ChillPulse/omnia-v-core/docs/ST7789_8080_8P_MOD_GUIDE.png

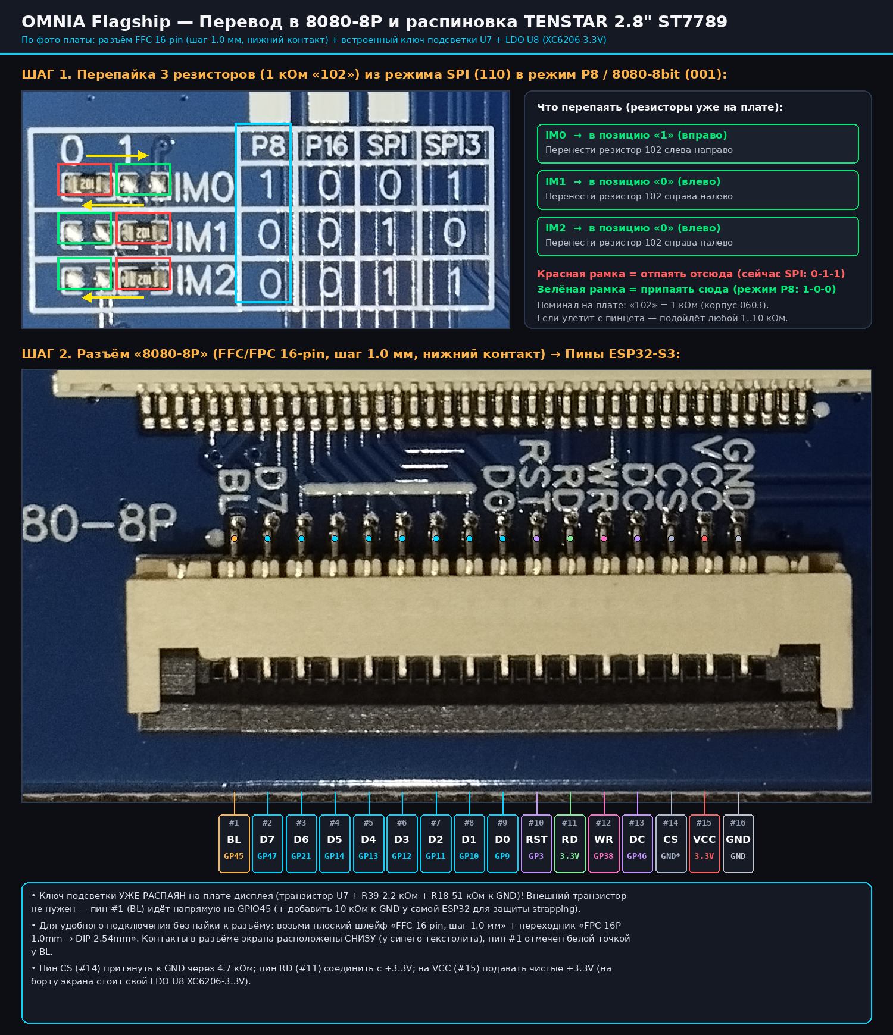
docs/ST7789_8080_8P_MOD_GUIDE.png
