ChillPulse/omnia-v-core/docs/OMNIA_MASTER_SPEC_v2.0.md

# OMNIA Flagship Streamer & Studio DSP — Единое Техническое Задание (Master Spec v2.0)

**Язык спецификации:** Русский (единый эталонный документ архитектуры, схемотехники, протоколов, DSP, UI/UX и плана разработки).  
**Статус документа:** `v2.0 Consolidated & Verified` — объединяет исходный *Master spec OMNIA (v-core) Draft 1.1* со всеми инженерными исправлениями пинов/питания, архитектурой PlatformIO, расширенным DSP (`AETHER Studio`, `Dynamic Loudness`, `A/B Compare`), движком `Zero-Stutter / True Gapless / Radio Time-Shift`, самообучаемым ИК-пультом и ультра-лёгкой PWA.  
**Назначение файла:** Долговременный эталон в рабочей среде (и будущем GitHub-репозитории проекта), исключающий потерю любых деталей между этапами разработки.

---

## 0. Первоисточники и строгая инженерная философия

### 0.1. Базовые референсы
* **Основной концепт OMNIA (v-core):** `https://github.com/ChillPulse/Info-spravka/blob/main/Master%20spec%20OMNIA%20(v-core)`
* **Вспомогательная кодовая база и референсы:**
  * `https://github.com/ChillPulse/Youradio_Omnia_ESP32S3`
  * Наработки STM/I2S из `Info-spravka` (`main.c`, `hal_msp`, `it.c`) — эталон чистого переключения мастер/слейв I2S и бесщёлчковой смены частоты дискретизации (`Fs`).
* **Аппаратная документация (Datasheets):**
  * `ESP32-S3-WROOM-1-N16R8` (16 МБ Quad Flash + 8 МБ Octal PSRAM) и распиновка 44-pin `ESP32-S3-DevKitC-1` (включая особенности китайских клонов и strapping-пинов `0, 3, 45, 46`).
  * `Artery AT32F403ACGU7` (`WeAct BlackPill`, Cortex-M4F 240 МГц с FPU, 1 МБ Flash, 96+128=224 КБ SRAM через `EOPB0`, полнодуплексный `I2S2 + I2S2EXT`).
  * Дисплей `TENSTAR ROBOT 2.8" IPS ST7789 (320×240)` в режиме **8-bit 8080 Parallel (`I80`)** + драйвер ESP-IDF `esp_lcd_i80`.
  * Периферия: `PCM5102A` (GY-PCM5102 purple module), `FSUSB30MUX` (MSOP-10), `74HC125`, `SN74AHCT125N`, `AO3401` + `PPTC 1812 0.75A`, `BH1750` (`0x23`), `TSOP38238/4838` (38 кГц), кольцо `12× WS2812B`, открытый каталог `Radio Browser API`.

### 0.2. Ключевые архитектурные принципы (нерушимые правила)
1. **Только нативный стек без Arduino:**
   * `ESP32-S3`: **строго ESP-IDF v5.x** с флагами оптимизации `-O3 -flto`.
   * `AT32F403`: **строго Artery V2 Firmware Library (`at32firmlib`) / CMSIS + аппаратный FPU** (`-O3 -ffast-math -mfloat-abi=hard -mfpu=fpv4-sp-d16`).
   * Единый монорепозиторий под **VS Code + PlatformIO** (сборка и прошивка обоих МК из одного окна выбора окружений + прямое обновление через Git).
2. **Строго двухпроцессорная схема (без третьего МК `RP2040-Zero` и без расширителя `PCF8575`):**
   * Родных GPIO хватает полностью при правильной инженерной разводке.
   * Оба порта USB (`USB-A` под флешку и `USB-C` под вход `USB-DAC` от ПК/Android/ТВ-бокса) работают через `FSUSB30MUX` с **горячим переключением ролей `Host MSC ↔ Device UAC1` на лету (~0.5 с без перезагрузки ESP32-S3)**.
   * Шина `I2C` (`GPIO2 / GPIO39`) остаётся доступной для опционального расширения в будущем.
3. **Честный Bit-Perfect и Политика частот `Policy 1` (MVP):**
   * Базовые частоты MVP: **`44.1 кГц` и `48 кГц`** (16/24-bit в 32-битном контейнере I2S). Никакого принудительного ресемплинга при совпадении частот. *(В фазе 2 заложен резерв под SRC / 88.2–96 кГц).*
   * При полностью выключенных блоках обработки (`Bypass ALL`) и громкости `0.0 dB (100%)` данные проходят сквозь `AT32` математически бит-в-бит (`Bit-Perfect Direct`).
   * Любая смена частоты `44.1 ↔ 48 кГц` или смена физического источника проходит строго через **Mute-Handshake** (плавный фэйд → стоп DMA → перестройка PLL/делителей → старт DMA → снятие Mute без единого щелчка).
4. **Разделение вычислительной тяжести (0% троттлинга):**
   * **Весь по-сэмпловый realtime DSP** крутится исключительно на `AT32F403` (расчётная пиковая загрузка со всеми включёнными блоками — `~27%` от 240 МГц).
   * **На `ESP32-S3`** Ядро 1 изолировано под аудиоконвейер (декодирование, буферы, I2S Slave TX, векторный 512-точечный FFT на PIE-инструкциях), а Ядро 0 ведёт `LVGL 60 FPS` по параллельной шине `I80 DMA`, сеть, индексы и управление.
   * **Веб-морда (PWA) максимально разгружает ESP32:** вся математика кривых АЧХ биквадов, парсинг REW/AutoEQ и отрисовка графиков выполняются **на процессоре смартфона/ПК**. Спектроанализатора в веб-морде нет (он живёт только на TFT-экране стримера), поэтому при открытой вкладке фоновый трафик по WebSocket равен **0%**.

---

## 1. Среда разработки, сборка и прошивка (VS Code + PlatformIO)

### 1.1. Структура монорепозитория
```text
omnia-streamer/
├── platformio.ini              # Единый конфиг сборки обоих МК (env:esp32s3_omnia и env:at32f403_dsp)
├── docs/
│   └── OMNIA_MASTER_SPEC_v2.0.md
├── shared/                     # Общие заголовки для 100% бинарной совместимости обоих МК
│   ├── omnia_pins.h            # Финальная карта пинов ESP32-S3 и AT32F403
│   ├── omnia_protocol.h        # Команды, фрейминг 0xAA55, packed-структуры DSP и статусов
│   └── omnia_crc16.h           # Общий табличный/быстрый CRC16-CCITT
├── esp32_firmware/             # Прошивка ESP32-S3 (ESP-IDF v5.x)
│   ├── CMakeLists.txt
│   ├── partitions.csv          # Разметка 16 МБ Flash (Dual OTA + LittleFS ~9.8 МБ)
│   ├── sdkconfig.defaults      # -O3, Octal PSRAM 80MHz, FreeRTOS Core affinity, TinyUSB
│   └── main/                   # Модули: audio_pipe, decoder, gapless, radio, ui_lvgl, ir_learn, web_pwa, uart_link
├── at32_firmware/              # Прошивка AT32F403ACGU7 (Artery BSP + CMSIS/FPU)
│   ├── ldscripts/              # Скрипт линковки с поддержкой 224 КБ SRAM и Dual-Slot OTA
│   └── src/                    # system_sram224, i2s_fullduplex, dsp_chain, aether, spi_flash_sfdp, anti_pop, uart_slave
└── web_pwa/                    # Исходники лёгкой PWA + скрипт упаковки в одиночный .gz для LittleFS
```

### 1.2. Как прошиваются оба микроконтроллера
1. **Первичная прошивка на столе из VS Code:**
   * `ESP32-S3`: кабель Type-C в разъём `UART/COM` на плате DevKitC-1 → выбор профиля `env:esp32s3_omnia` на нижней панели PlatformIO → кнопка `Upload`.
   * `AT32F403 BlackPill`: выбор профиля `env:at32f403_dsp` → прошивка либо через копеечный `ST-Link V2 / CMSIS-DAP` по 4 проводам (`SWDIO, SWCLK, GND, 3.3V`) в одно нажатие `Upload`, либо вообще без программатора обычным кабелем Type-C в саму BlackPill (зажать `BOOT0` + нажать `NRST` → режим USB DFU через `Artery ISP CLI`).
2. **Штатное обновление в собранном корпусе (`Smart Dual-OTA`):**
   * Через смартфон/ПК (PWA) или с флешки подаётся единый архив `omnia_update.pkg` (`manifest + esp32.bin + at32.bin + pwa.gz`).
   * `ESP32-S3` обновляет себя в неактивный раздел `ota_0 / ota_1`, а прошивку `AT32` перегоняет чанками по внутренней шине UART1 (`921600+` бод) во второй банк внутренней памяти `AT32` (или на внешнюю SPI-флешку AT32) со строгой проверкой `CRC32` и автоматическим откатом при сбое питания.

---

## 2. Финальная инженерная распиновка (100% без конфликтов)

### 2.1. `ESP32-S3-DevKitC-1 N16R8` (44-pin)
> **Важные правила безопасности:**
> * Пины **`GPIO35, GPIO36, GPIO37`** физически заняты внутренней 8-линейной шиной **Octal PSRAM** — в коде и на плате **строго не подключаются**.
> * На китайских клонах `N16R8` eFuse напряжения флеш-памяти (`VDD_SPI`) может быть не прожжён, поэтому strapping-пин **`GPIO45` при старте обязан быть притянут к `GND` (`LOW`)** — внешние подтяжки к `3.3V` на нём запрещены!

| Подсистема | Линия / Сигнал | Пин ESP32-S3 | Электрический режим и примечания |
| :--- | :--- | :---: | :--- |
| **Отладка / Прошивка** | `UART0 TX / RX` | **`43` / `44`** | Штатный мост USB-UART на плате DevKitC-1 (логи и прошивка). |
| **Выделенный USB Host** | `USB D− / D+` | **`19` / `20`** | **Напрямую на гнездо `USB-A` («Флешка / HDD»)** без мультиплексора `FSUSB30MUX`! Питание `+5V` гнезда через предохранитель `PPTC 0.5–0.75A`. |
| **Дисплей I80 (8-bit)** | Шина данных `D0..D7` | **`9, 10, 11, 12, 13, 14, 21, 47`** | Прямые быстрые GPIO `esp_lcd_i80` (`D0=GP9 .. D5=GP14`, `D6=GP21`, `D7=GP47`), строго по порядку контактов `#9..#2` разъёма `8080-8P` без перехлёста жил! |
| **Дисплей I80** | `WR` (PCLK 20–40 МГц) | **`38`** | Пин `#12` разъёма `8080-8P`. *(Если на плате v1.1 распаян бортовой RGB-диод на GPIO38 — разомкнуть перемычку `RGB`)*. |
| **Дисплей I80** | `DC` (Data/Command) | **`46`** | Пин `#13` разъёма `8080-8P`. Строго выход без внешней подтяжки к `3.3V`. |
| **Дисплей I80** | `RST` (Аппаратный сброс) | **`3`** | Пин `#10` разъёма `8080-8P`. Строго выход без внешней подтяжки. |
| **Дисплей I80** | `BL` (ШИМ подсветки) | **`45`** | Пин `#1` разъёма `8080-8P` **напрямую** (транзисторный ключ `U7 + R39 2.2k + R18 51k` уже распаян на самом дисплее!). У ножки `GPIO45` ставится только `10 кОм` на `GND` для защиты strapping при отключённом шлейфе. |
| **Дисплей I80** | `CS`, `RD`, `VCC`, `GND` | **Аппаратно** | На `8080-8P`: `#14 (CS)` → к `GND` через `4.7 кОм` (`cs_gpio_num = -1`); `#11 (RD)` → `+3.3V`; `#15 (VCC)` → `+3.3V` (на борту экрана свой LDO `U8 XC6206-3.3V`); `#16 (GND)` → `GND`. |
| **Карта памяти SD (SPI)** | `MOSI, SCK, MISO, CS` | **`15, 16, 17, 18`** | Выделенный контроллер `SPI2/SPI3` DMA, опциональные подтяжки `10–47 кОм` к `3.3V` на линиях данных/CS. |
| **Аудиовыход 24-bit в AT32** | `BCLK, DOUT, LRCK` | **`4` (BCK in), `5` (DOUT out), `6` (WS in)** | Режим **I2S Slave TX (24-bit в 32-bit слотах)**: тактируется от мастера `AT32`; `GPIO5` идёт **напрямую** на `AT32 PB14` (микросхема `74HC125` исключена!). |
| **Канал связи с AT32** | `UART1 TX / RX` | **`7` (TX → PA10), `8` (RX ← PA9)** | Аппаратный UART DMA `921600 – 2 000 000` бод (протокол `0xAA55`, Триггер USB-DAC, метаданные BT `aptX-HD` + OTA). |
| **Шина датчика света** | `I2C SDA / SCL` | **`2` (SDA), `39` (SCL)** | Подтяжки `4.7 кОм` к `3.3V`. Подключён люксметр `BH1750` (`0x23`) + запас под любые I2C-модули. |
| **Энкодер навигации** | `ENC_A, ENC_B, ENC_BTN` | **`41` (A), `42` (B), `0` (BTN)** | Аппаратный модуль счёта импульсов `PCNT` + RC-фильтр `10k + 10–100nF`. Удержание ручки (`GPIO0`) при подаче питания даёт сервисный вход в загрузчик! |
| **Обучаемый ИК-порт** | `IR_RX` (`TSOP38238`) | **`40`** | Аппаратный захват таймингов `RMT RX` + RC-развязка питания TSOP (`100 Ом + 4.7 мкФ`). |
| **Клавиатура 7 кнопок** | `ADC_KEYS` | **`1` (`ADC1_CH0`)** | Резистивная матрица на `ADC1` (не конфликтует с Wi-Fi, калибровка `esp_adc_cal` + гистерезис). |
| **Светодиодное кольцо** | `RGB_DIN` (`12× WS2812B`) | **`48`** | Аппаратный `RMT TX` → согласователь уровня 5V (`SN74AHCT125N` или 1 диод питания на первом диоде) → `330 Ом` → `DIN`. |

---

### 2.2. `WeAct AT32F403ACGU7 BlackPill V1.0` (Cortex-M4F @ 240 МГц — Архитектура `Zero-Mux 24-Bit`)
> **Аппаратное раскрытие памяти при первом старте (`Extend_SRAM`):**  
> При загрузке проверяется пользовательский байт `EOPB0` по адресу `0x1FFFF810`. Если там заводское значение `0xFF` (`96 КБ SRAM`), прошивка один раз программирует `EOPB0 = 0xFE` и делает системный сброс, открывая **все `224 КБ SRAM`** (буферы Room Delay `20 мс`, Studio AETHER, Farrow ASRC и 24-битный FIFO звуковой карты USB-DAC размещаются в `.sram_ext`).

| Подсистема | Линия / Сигнал | Пин AT32F403 | Электрический режим и примечания |
| :--- | :--- | :---: | :--- |
| **Отладка / Прошивка** | `SWDIO` / `SWCLK` | **`PA13` / `PA14`** | 4-контактная колодка `SWD` на торце BlackPill (`SWJTAG_GMUX_010` сохраняет SWD и освобождает `PA15/PB3/PB4`). |
| **Нативный вход USB-DAC** | `USB_DM` / `USB_DP` | **`PA11` / `PA12`** | **Встроенная звуковая карта `UAC 1.0 Async 24-bit / 48 (44.1) кГц`** (`HICK 48 МГц + ACC`, без драйверов на Android TV, Windows, macOS, Linux, iOS). Также поддерживает прошивку `DFU` по кнопке `BOOT0`. |
| **Триггер +5V USB-DAC** | `USB_VBUS_DET` | **`PB9`** | Делитель **`10 кОм / 15 кОм + 100 нФ`** от `+5V VBUS` входного гнезда USB-DAC (+ резерв по пакетам `USB SOF`). Включаемое из Web-UI/меню автопереключение входа, пробуждение из Standby и автовозврат! |
| **Шина I2S2 (Master)** | `LRCK (WS)` / `BCLK (CK)` | **`PB12` / `PB13`** | `AT32` — **единственный тактовый мастер I2S** в системе (раздаёт эталонный клок и на `ESP32`, и на `PCM5102A`). |
| **Шина I2S2 (Full-Duplex)** | `SDEXT (RX)` / `SD (TX)` | **`PB14` (вход), `PB15` (выход)** | `PB14` принимает 24/32-битный поток **напрямую** с `ESP32 GPIO5`; `PB15` отдаёт обработанный 24/32-битный поток на `DIN` ЦАПа `PCM5102A`. |
| **Мастер-клок ЦАПа** | `I2S2_MCK (256×Fs)` | **`PA3`** | Выход синхронного `MCLK` (`SPI2_GMUX_0001`, задел под старшие ЦАПы `ES9038Q2M / AK4493S`). |
| **Прямой вход Bluetooth** | `I2S3_WS, CK, SD` | **`PA15, PB3, PB5`** | Второй аппаратный порт **`I2S3 Slave RX`** (`SPI3_GMUX_0010` + `DMA2_Channel1` + кубический **Farrow ASRC**): принимает 24-bit поток от `SJR-BTM334 (QCC3034 aptX-HD)` или `BT401 Master` без `74HC125`! |
| **Мост метаданных BT** | `UART4 TX, RX` + `BT_RST` | **`PA0, PA1`** + **`PA2`** | Ремап `UART4_GMUX_0010` (`115200 8N1`): приём тегов `AVRCP 1.6` и кодека `aptX-HD` от `BTM334` + совместимость с AT-командами `BT401`; `PA2` — сброс/спаривание BT. |
| **Связь с ESP32-S3** | `USART1 TX / RX` | **`PA9` (TX), `PA10` (RX)** | DMA приём/передача пакетов управления, метаданных и OTA (`PA9 → GPIO8`, `PA10 ← GPIO7`). |
| **Анти-поп и Реле** | `DAC_XSMT, AMP_MUTE, RELAY` | **`PB0, PB4, PB8`** | Разведены на чистые пины с подтяжками `10 кОм` к `GND` (`LOW` при старте = полная тишина), **не занимая ни одного вывода нижней флешки `U3`**! |
| **Универсальная Flash** | `U3 SOIC-8` и `SPI1` | **`PA8/PB1/PB10/PB11/PB6/PB7`** и **`PA4..PA7`** | Автоопрос `JEDEC + SFDP` сразу на **обеих** площадках (штатное место `U3` на брюшке WeAct BlackPill и внешняя шина `SPI1`). Если не распаяна — откат во внутреннюю 1 МБ Flash AT32. |

---

## 3. Узлы схемотехники Zero-Mux 24-Bit и выбор частоты USB-DAC

1. **Отказ от внешних мультиплексоров (`Zero-Mux 24-Bit`) и разделение портов USB:**
   * Микросхемы `FSUSB30MUX`, `74HC125` и транзисторный ключ раздачи питания USB-A **полностью исключены из тракта** (купленные `FSUSB30MUX` остаются в ЗИП):
     * **Гнездо `USB-A` («Флешка / HDD»)** подключено напрямую к `ESP32-S3 GPIO19 (D−) / GPIO20 (D+)`. Питание `+5V` подаётся постоянно через самовосстанавливающийся предохранитель **`PPTC 0.5–0.75A`** и конденсаторы `100 мкФ + 100 нФ` — флешка никогда не размонтируется при включении ПК или ТВ-бокса!
     * **Вход звуковой карты `USB-DAC` (гнездо `USB-C` или `USB-B` на задней панели, либо штатный разъём на BlackPill)** подключён напрямую к `AT32 PA11 (D−) / PA12 (D+)` через резисторы `22 Ом` (на гнезде `USB-C` линии `CC1/CC2` притянуты двумя резисторами **`5.1 кОм` к `GND`**).
2. **Инженерное обоснование выбора `24-bit / 48 кГц (+ 44.1 кГц)` вместо `96 кГц` для USB-DAC:**
   * **Огромный запас мощности под будущие улучшения DSP:** при `48 кГц` все 9 студийных каскадов `32-bit float` потребляют всего **`~29%` ядра AT32 (`240 МГц`)**, оставляя **`>70%` (`~170 MIPS`) свободного ресурса** и половину расширенной SRAM под любые новые алгоритмы (FIR-кроссоверы, многополосный компрессор, динамический EQ). На `96 кГц` нагрузка удваивается до `~60%`, а линии задержки требуют вдвое больше памяти.
   * **100% нативное совпадение с ТВ-приставками, кино и YouTube:** звуковой движок Android TV (`AudioFlinger`), фильмы, сериалы и концертные дорожки работают строго в сетке **`48 кГц`** (а музыкальные плееры — в `44.1 / 48 кГц`), что исключает двойной программный ресемплинг ОС.
   * **Максимальная надёжность USB Full-Speed без микро-заиканий:** поток `24-bit / 48 кГц` занимает всего **`288 байт/мс` (`< 28%` шины Full-Speed)** и работает по встроенному во все ОС драйверу **`UAC 1.0 Asynchronous`** с явной обратной связью `10.14` (`Endpoint 0x82`), тогда как `24-bit / 96 кГц` (`576–582 байт/мс`) упирается в потолок изохронного буфера и капризничает на бюджетных Android TV боксах.
   * **Точность суббасовых фильтров и внутренний оверсэмплинг ЦАПа:** при `48 кГц` полюса `32-bit float` биквадов на `20–45 Гц` (Room PEQ / VBB) вдвое точнее, чем на `96 кГц`, а сам ЦАП `PCM5102A` аппаратно выполняет внутренний `8×` оверсэмплинг до `384 кГц`.
3. **Включаемая Триггер-функция звуковой карты USB-DAC (`PB9 VBUS_DET` + `USB SOF`):**
   * Линия `+5V VBUS` входного разъёма `USB-DAC` **изолирована** от внутреннего блока питания стримера и подаётся на делитель **`10 кОм` (верхний) / `15 кОм` (нижний на `GND`) + `100 нФ`** → пин **`AT32 PB9`** (`+3.0 В = HIGH` при включении ТВ-бокса, ПК или смартфона по OTG). Дополнительно в прошивке работает программный детектор пакетов `USB SOF`, поэтому триггер работает даже при стендовой проверке через штатный разъём Type-C на самой BlackPill!
   * В Web-UI (PWA) и меню экрана доступен переключатель **`Авто-триггер USB-DAC` (`OMNIA_CMD_USB_TRIGGER_CFG`, сохраняется в NVS)**:
     * **Если ВКЛ:** подача `+5V` от ТВ-бокса/ПК (антидребезг `150 мс`) автоматически выводит стример из Standby, ставит веб-радио/плеер на паузу и бесщёлчково переключает тракт на `USB-DAC 24-bit`. При выключении ТВ-бокса (пауза отпускания `800 мс` против ложных срабатываний на перезагрузках) стример сам возвращается на предыдущий источник! Если пользователь вручную переключил вход при включённом ПК, ручной выбор уважается до следующего физического включения USB-хоста.
     * **Если ВЫКЛ:** появление `+5V` на USB не переключает активный вход — выбор `USB-DAC` выполняется только вручную кнопкой/пультом/Web-UI.
4. **Прямой цифровой вход Bluetooth `SJR-BTM334 (QCC3034 24-bit aptX-HD)` и совместимость с `BT401 Master`:**
   * Модуль **`SJR-BTM334` (`QCC3034`)** с кастомной прошивкой `OMNIA-BTM334` (`ADK 6.x`: `24-bit I2S Master` + `AVRCP 1.6 UART`) подключается напрямую ко второму I2S-порту AT32: `Pin 4 (PIO17 WS) → PA15`, `Pin 5 (PIO16 SCK) → PB3`, `Pin 3 (PIO18 SD) → PB5`, `UART TX/RX → PA1/PA0` (`115200`), **`Pin 24 (VDD_PADS_1) → +3.3V`** (перевод логики PIO на `3.3 В`!).
   * На время стендовой сборки до перепрошивки `BTM334` на те же самые пины (`PA15/PB3/PB5` и `PA0/PA1`) без единой переделки встаёт имеющийся модуль **`BT401 Master`** — прошивка `AT32` автоматически распознаёт и `16/24-bit` поток через кубический ресемплер **Farrow ASRC**, и оба протокола команд `UART4`!
5. **Модуль ЦАП `PCM5102A` (фиолетовая плата `GY-PCM5102` + совместимость со старшими ЦАП):**
   * Перемычки на обороте фиолетовой платы: `1 (FLT) = L`, `2 (DEMP) = L`, `4 (FMT) = L` (стандартный I2S). Площадка **`3 (XSMT)` остаётся разомкнутой**, а пин `XSMT` подключается к `AT32 PB0` (с подтяжкой `10 кОм` к `GND` для железной защиты от щелчка при включении).
   * Пин `SCK` сажается на `GND` (внутренний PLL `PCM5102A`) или через джампер на `AT32 PA3 (MCLK 256fs)`.
   * Питание `VIN` подаётся от чистой линии `+5V` (через LC/RC фильтр на собственный стаб платы) либо от отдельного малошумящего LDO `3.3V`; аналоговый выход с пост-фильтром `470 Ом + 2.2 нФ`. Звезда аналоговой и цифровой земель сводится непосредственно у ЦАПа.
6. **Согласование кольца `12× WS2812B`:**
   * Буфер `SN74AHCT125N` запитан от **`+5V`** (порог логической единицы серии `AHCT` равен `2.0 В`, что идеально читает `3.3 В` от `ESP32 GPIO48` и выдаёт честные `5.0 В` на ленту). На входе `10 кОм` к `GND`, последовательно с выходом `330 Ом`, по питанию кольца электролит `470–1000 мкФ`.
7. **Универсальная внешняя SPI-память на `AT32` (автоопрос сразу `U3 SOIC-8` на брюшке BlackPill и внешней шины `SPI1 PA4–PA7`, опционально):**
   * Можно запаять **абсолютно любой чип 25-й серии 3.3V в корпусе SOIC-8 объёмом от 1 до 16+ МБ** (*Winbond, GigaDevice, Boya, Puya, Zbit, Macronix, XMC*) как прямо на штатную площадку `U3` снизу WeAct BlackPill (`PA8/PB1/PB10/PB11/PB6/PB7`), так и на внешние пины `PA4–PA7`. Драйвер сам читает `JEDEC ID (0x9F)` и геометрию стирания из стандартизированной таблицы `SFDP (0x5A)`. Если микросхема не запаяна — `AT32` автоматически хранит пресеты во внутренней Flash (1 МБ).
8. **Модификация и подключение дисплея `TENSTAR 2.8" ST7789` (подтверждено по макро-фото печатной платы, см. `ST7789_8080_8P_MOD_GUIDE.png`):**
   * **Перевод матрицы из `SPI (IM2=1, IM1=1, IM0=0)` в `8-bit 8080 P8 (IM2=0, IM1=0, IM0=1)`:** перепаять три штатных резистора `102` (`1 кОм`, 0603) в соседние посадочные площадки: **`IM0`: из `0` → в `1` (вправо)**; **`IM1`: из `1` → в `0` (влево)**; **`IM2`: из `1` → в `0` (влево)**.
   * **Физический разъём `8080-8P`:** SMD ZIF-сокет под плоский шлейф **`FFC/FPC 16-pin с шагом 1.0 мм`**, **нижний контакт (Bottom Contact)**, выдвижной чёрный замок. Для подключения к макету/плате без мелкой пайки используется стандартный шлейф `FFC 16P 1.0mm` + переходник `FPC-16P 1.0mm → DIP 2.54mm` (или ответный разъём `FPC-16P 1.0mm` на общей плате).
   * **Точная цоколёвка разъёма `8080-8P` (слева направо от белой метки `●` у пина `#1`):**
     `#1: BL (GP45)` | `#2: D7 (GP47)` | `#3: D6 (GP21)` | `#4: D5 (GP14)` | `#5: D4 (GP13)` | `#6: D3 (GP12)` | `#7: D2 (GP11)` | `#8: D1 (GP10)` | `#9: D0 (GP9)` | `#10: RST (GP3)` | `#11: RD (+3.3V)` | `#12: WR (GP38)` | `#13: DC (GP46)` | `#14: CS (GND через 4.7k)` | `#15: VCC (+3.3V)` | `#16: GND`.
   * **Бортовая обвязка экрана:** стабилизатор `U8 = XC6206P332MR (3.3V)` и транзисторный ключ подсветки `U7` (`R39 = 2.2 кОм` в базу/затвор, `R18 = 51 кОм` к `GND`, `R40 = 3.0 Ом` балласт светодиодов) **уже установлены на модуле дисплея** — внешний транзистор для `BL` не требуется.

---

## 4. Студийный DSP-тракт на `AT32F403` (240 МГц FPU)

Обработка ведётся в `32-bit float` (биквады НЧ-диапазона `< 250 Гц` — с повышенной точностью или структурой **Direct Form II Transposed / SVF**, исключающей шумы квантования на глубоком басе). Любое изменение параметров или переключение пресетов сопровождается плавной косинусной/линейной интерполяцией **`20–50 мс` без щелчков**.

### 4.1. Строгий порядок звеньев цепочки (неизменный)
```text
[I2S RX 32-bit]
   │
   ▼
1. Input Sanitizer & DC/Subsonic HPF  ──► Фильтр 2-го порядка Баттерворта (15–35 Гц, по умолч. 20 Гц, Q=0.707, отключаемый) + защита от NaN/Inf.
   │
   ▼
2. Dynamic Headroom Manager           ──► Автоматический/ручной пред-аттенюатор (0..-18 dB) пропорционально пикам плюсового усиления PEQ/VBB/AETHER.
   │
   ▼
3. Room Acoustic PEQ (5 полос)        ──► Модальная коррекция комнаты (PK / LS / HS / LP / HP / Notch / AllPass) из room.json / REW / AutoEQ.
   │
   ▼
4. User Parametric EQ (10 полос)      ──► Пользовательский 10-полосный параметрик (f0: 20..20000 Гц, Q: 0.1..16.0, Gain: -18..+18 dB; протокол расширяем до 15).
   │
   ▼
5. Anti-Ad AGC (Анти-реклама)         ──► Режимы OFF / Soft / Aggro (мягкое удержание громких рекламных скачков на потоках без «насосного» эффекта на музыке).
   │
   ▼
6. VBB / Psychoacoustic Bass          ──► Виртуальный психоакустический бас (40..120 Гц): режимы Clean Shelf / Even+Odd Harmonics / Missing Fundamental + Drive + LP + Mix.
   │
   ▼
7. Studio AETHER Processor (Эфир)     ──► Полностью плавно настраиваемый M/S-процессор сцены, воздуха, глубины, ламповой теплоты и наушникового Crossfeed (см. п. 4.2).
   │
   ▼
8a. Dynamic Loudness (ISO 226)        ──► Умная тонкомпенсация под текущую громкость (плавно исчезает к референсному уровню).
   │
   ▼
8b. Room Time-Alignment & Phase       ──► Физическое выравнивание времени прихода АС (независимые суб-сэмпловые линии задержки L/R 0.00..20.00 мс с шагом 0.01 мс ≈ 3.4 мм в .sram_ext, калибровочный трим L/R -12..+6 dB и переворот фазы 0°/180°). Выполняется ПОСЛЕ M/S-матрицы AETHER, чтобы не вносить гребенчатый фазовый перекос внутри AETHER!
   │
   ▼
8c. Master Volume + A/B RMS-Match     ──► По-сэмпловый Smoother громкости, баланс L/R и бесшовное мгновенное сравнение A/B с автовыравниванием RMS.
   │
   ▼
9. Final True-Peak Safety Limiter     ──► Лимитер с предпросмотром (Look-ahead 1.5–3.0 мс с удержанием пикового минимума в .sram_ext, потолок -0.5..-1.0 dBFS + DC-guard) + TPDF Dither.
   │
   ▼
[I2S TX 32-bit → PCM5102A]
```

### 4.2. Полная математика и параметры флагманского блока `AETHER` («Эфир»)
Каждая ручка имеет индивидуальный сглаживатель (`1-pole smoother`), чтобы при вращении ползунка со смартфона звук «дышал» и перетекал как на аналоговой консоли:

1. **`master_blend` (`0.0 .. 1.0`)** — общая глубина подмешивания всего блока `AETHER` одной макро-ручкой (доступна в том числе прямо с энкодера на экране стримера).
2. **Разложение Mid/Side и якорь вокала:**
   * `M = 0.5 * (L + R) * center_anchor_gain` (`center_anchor_db`: `-6.0 .. +6.0 dB` — удерживает телесность вокала при широкой панораме);
   * `S = 0.5 * (L - R)`.
3. **Фундамент баса (`Sub-Bass Mono Lock` + `Side HPF`):**
   * Фазолинейный/Линквиц-Райли кроссовер `bass_xover_hz` (`40 .. 250 Гц`): всё ниже частоты раздела в `S`-канале мягко собирается в моно, чтобы бочка и бас били упруго и сфокусированно из центра;
   * Дополнительный фильтр `side_hpf_hz` (`20 .. 180 Гц`) очищает боковую составляющую от противофазного гула комнаты.
4. **Шёлковый воздух без сибилянтов (`Silk Air` + `De-Harsh`):**
   * Высокочастотный шельф/колокол в `S` (и частично `M`) канале: `air_gain` (`0.0 .. +8.0 dB`), `air_freq_hz` (`5500 .. 16000 Гц`), `air_q` (`0.4 .. 1.6`);
   * Динамический детектор огибающей ВЧ `de_harsh` (`0.0 .. 1.0`): при всплеске резких согласных «с-ц-ш» мгновенно придерживает подъём `Silk Air`, сохраняя хрустальную прозрачность без утомления слуха.
5. **Трёхмерный эшелон сцены вглубь (`3D Stage Depth`):**
   * Каскад фазовых `All-Pass` декорреляторов и микро-линия задержки (`0.4 .. 12.0 мс` в `224 КБ SRAM`): параметры `depth_amount` (`0.0 .. 0.45`) и `stage_size` (`0.0 .. 1.0`) создают ощущение объёма *за* плоскостью акустики без окраски гребенчатого фильтра.
6. **Ламповая чётная гармоника (`Triode Warmth`):**
   * Мягкий асимметричный шейпер `harmony_drive` (`0.0 .. 0.30`) с отсечкой постоянной составляющей — обогащает середину благородной 2-й гармоникой.
7. **Расширение сцены и режим наушников (`Stage Width` & `Headphone Crossfeed`):**
   * `width` (`0.0 .. 2.0`, где `0.0` = чистое моно, `1.0` = оригинал, `>1.0` = расширенная панорама);
   * Отдельный переключатель `crossfeed_en` (`crossfeed_level 0..1`, `crossfeed_fc 500..900 Гц`, задержка ~`260 мкс`) для прослушивания в наушниках без эффекта «звука внутри черепа».
8. **Заводские пресеты `AETHER` из коробки:** `OFF (Bit-Perfect)`, `Natural Studio`, `Wide Holographic`, `Silk Air & Vocal`, `Tube Lounge`, `Concert Hall`, `Headphone Stage`.

### 4.3. Честное мгновенное сравнение `A/B Instant Compare`
При нажатии кнопки `A/B` (с пульта, экрана или телефона) `AT32` за `25 мс` переключает обработанный сигнал на чистый входной поток, **автоматически выравнивая громкость по скользящему окну RMS/LUFS**, чтобы слушатель оценивал реальное улучшение тембра и сцены, а не обманывался разницей в громкости на `1–2 дБ`.

---

## 5. Флагманский аудиоплеер на `ESP32-S3` (`Zero-Stutter`, `Gapless`, `Radio Time-Shift`)

### 5.1. Трёхконтурная архитектура памяти без единого троттла и фриза
1. **Нулевая фрагментация кучи (24/7 Uptime):** все крупные буферы размечаются один раз при загрузке в статических пулах `PSRAM` и `SRAM`.
2. **Контур 1 — Сжатый потоковый/файловый кэш (`1.5 МБ` в Octal PSRAM):** принимает данные с USB-флешки, SD-карты, SMB/DLNA или интернет-радио; хранит историю живого радиоэфира для перемотки назад.
3. **Контур 2 — Декодированный буфер `PCM Ring` (`2.5 МБ` в Octal PSRAM):** ~13 секунд готового несжатого стереопотока между декодером (`FLAC / MP3 / AAC-HE / Opus / Ogg Vorbis / WAV`) и отдачей в I2S.
4. **Контур 3 — Изолированный буфер `I2S DMA` (`24 КБ` во внутренней быстрой SRAM):** защищает звук от микро-пауз шины PSRAM в моменты записи настроек в NVS/LittleFS. Приоритет задачи отдачи I2S на `Core 1` — максимальный (`configMAX_PRIORITIES - 2`).

### 5.2. Настоящий `Gapless` (воспроизведение с флешки/SD без пауз сэмпл-в-сэмпл)
* **Фоновое пред-открытие (`Lookahead Open`):** за 5 секунд до окончания текущего файла задача чтения уже открывает следующий трек, парсит его теги, пропускает блок встроенной картинки обложки и ставит первые аудиофреймы встык в общую очередь.
* **Точная обрезка пустых сэмплов кодировщика:**
  * Для `FLAC` и `WAV` с одинаковой частотой (`44.1 → 44.1` или `48 → 48 кГц`) переход идёт **непрерывным потоком сэмплов без остановки `I2S DMA` и без закрытия `Mute` на `AT32`**.
  * Для `MP3` и `AAC/M4A` парсер считывает служебные заголовки `Xing / LAME Info / iTunSMPB` (`encoder_delay` и `encoder_padding`) и математически отрезает пустые стартовые и хвостовые отсчёты — концертные альбомы и DJ-сеты в MP3 играют без малейшей «ступеньки»!
* **Нативная поддержка `CUE + единый FLAC/WAV`:** образы целых CD-дисков отображаются в библиотеке как полноценные альбомы с отдельными треками, мгновенным переходом по таймкодам `INDEX 01` и автоопределением русской кодировки (`UTF-8 / Windows-1251`).
* **Умный `Crossfade` и `ReplayGain`:** в режиме случайного воспроизведения (`Shuffle`) можно включить плавный перекрёстный микс треков (`1–6 с`); теги `ReplayGain (Track / Album)` считываются из файлов и плавно компенсируют разброс громкости разных записей.

### 5.3. Локальная библиотека на 10 000+ треков, закладки и эластичная перемотка
* **Мгновенный браузер папок + Фоновый индекс `.omnia.db`:** флешка доступна через файловый проводник с первой секунды после подключения, пока фоновая задача собирает на носителе быстрый бинарный индекс по `Артистам / Альбомам / Жанрам / Годам` (повторное открытие занимает `~0.2 с`).
* **Безопасное сжатие тяжёлых обложек (`Scale-on-Decode`):** вшитые обложки вплоть до `3000×3000 px` масштабируются декодером JPEG на лету (`1/2, 1/4, 1/8`) прямо в целевой буфер `180×180 px` без переполнения памяти.
* **Авто-закладки (`Smart Bookmarks`):** для длинных файлов (`> 15 минут`: аудиокниги, подкасты, лайв-сеты) позиция остановки запоминается автоматически.
* **Эластичная ускоренная перемотка (`Smart Elastic Seek`):** при удержании `Next / Prev` (на кнопках, энкодере или ИК-пульте) скорость перемотки плавно разгоняется (`+5с → +15с → +30с → +60с`) пропорционально общей длительности трека с мягким микро-фэйдом `15 мс` и живым превью времени на экране.
* **Трёхуровневое Избранное + Жанровые полки (`Smart Genre Shelves`):**
  * Короткое нажатие `♥` — в главный список любимых треков/станций;
  * Удержание `♥` — выбор целевого пользовательского плейлиста (`Ночь`, `Драйв`, `Референс` и т.д.);
  * Автоматическая раскладка избранных треков и радиостанций по жанровым витринам (*Jazz, Rock, Electronic, Classical, Chillout*) с запуском волны в 1 клик.

### 5.4. Флагманская подсистема Интернет-Радио (`Radio Browser API` + `Time-Shift`)
* **Полный каталог `Radio Browser API` (`User-Agent: OMNIA-Streamer/2.0`):** поиск по названию, топовые станции, фильтрация по странам, языкам, тегам/жанрам и битрейту (включая отдельную вкладку **`Hi-Fi Lossless FLAC Radio`**), кэширование списка и иконок станций с TTL, поддержка `.pls / .m3u / .m3u8`, `HTTP/HTTPS` и цепочек редиректов `301/302`.
* **Быстрый старт за `0.6 с` (`Dual-Slope Prebuffer`):** воспроизведение стартует сразу по накоплению стартового порога (`96–128 КБ`), а глубокий анти-обрывный буфер (`25–40 с`) незаметно добирается в фоне.
* **Живая пауза и перемотка радио назад (`Radio Time-Shift`):** кольцевой сжатый буфер `1.5 МБ` удерживает последние **1.5–2 минуты живого эфира** — радио можно поставить на паузу, отмотать понравившийся фрагмент на 30–60 секунд назад и одной кнопкой `LIVE` вернуться к прямому вещанию!
* **Запись трека с радио «с самого начала» (`Retroactive Track Ripper`):** даже если нажать «Сохранить трек» на середине песни, стример забирает начало композиции из кольцевого кэша PSRAM по метке прошлой смены `ICY`-тега и дописывает чистый файл без перекодирования на USB-флешку/SD в папку `/Radio_Drops/Artist - Title.mp3`.
* **Ловец треков (`Radio Track Catcher`):** журнал последних 50 прозвучавших на радио песен с сохранением в блокнот «Находки» и кнопкой мгновенного поиска трека в смартфоне (PWA), плюс автоконвертер русских тегов `CP1251 → UTF-8` и подгрузка обложек играющей песни из открытого API iTunes/MusicBrainz.
* **Двойной анти-рекламный щит (`Anti-Ad 2.0`):** связка детектора рекламных маркеров в потоковых метаданных `ICY` (приглушение звука или временный 90-секундный прыжок на резервную чилл-станцию «Радио-сёрфер») + динамический выравниватель громкости `Anti-Ad AGC` на `AT32`.

---

## 6. Самообучаемый универсальный ИК-пульт (`Smart IR Learning & Macros`)

Подсистема позволяет за минуту «подружить» стример **с абсолютно любым домашним пультом** (от старого музыкального центра, телевизора Sony/LG/Samsung, приставки Apple TV или любого китайского пульта).

1. **Аппаратный захват без нагрузки на процессор (`ESP32-S3 RMT RX` на `GPIO40`):**
   * Модуль `RMT` аппаратно отсекает короткие световые помехи от ламп/экранов (`glitch filter ~1000 нс`) и фиксирует конец посылки по тишине `> 15 мс`, складывая массив точных микросекундных длительностей прямо в память по DMA.
2. **Всеядный двухслойный декодер протоколов:**
   * **Слой 1 (Штатные протоколы):** нативное распознавание `NEC / Extended NEC`, `RC5 / RC6` (с правильной обработкой `toggle-bit` для отличия удержания от двойного клика!), `Sony SIRC (12/15/20-bit)`, `Samsung32`, `LG`, `Panasonic/Kaseikyo`, `Apple Remote`.
   * **Слой 2 (Универсальный отпечаток `Raw Pulse Hash`):** если пульт использует нестандартный редкий протокол, анализатор квантует соотношения длительностей импульсов/пауз в инвариантную 64-битную сигнатуру `FNV-1a` — **обучается вообще любой ИК-пульт с несущей ~36–40 кГц!**
3. **Честная обработка удержания кнопок (`Repeat & Acceleration`):**
   * Поддержка коротких кадров повтора `NEC Repeat` и непрерывных пачек `Sony/RC5`: плавный разгон громкости при удержании `Vol+ / Vol−` и запуск эластичной перемотки `Smart Elastic Seek` при удержании `Next / Prev`.
4. **Интерактивный Мастер обучения (и на экране TFT, и со смартфона в PWA):**
   * Алгоритм **двойного подтверждения** («Нажмите кнопку на пульте → Нажмите ещё раз для проверки») исключает случайную запись бликов и мусора; при успехе экран показывает протокол/код, а RGB-кольцо мигает бирюзовым подтверждением.
   * Одновременная память **до 3 разных пультов** (например: основной Hi-Fi пульт + громкость/Mute от пульта телевизора + маленький прикроватный пульт) с сохранением в NVS и экспортом/импортом JSON-профиля через PWA.
5. **Назначаемые функции, Макросы и Умное пробуждение:**
   * Стандартные действия: `Power/Standby`, `Vol+`, `Vol−`, `Mute`, `Play/Pause`, `Next/Seek+`, `Prev/Seek−`, `Source Cycle`, `Like ♥`, `Catch Radio Track`, `Visualizer Mode`, `A/B DSP Compare`, `Sleep Timer`, навигация `Up/Down/Left/Right/OK/Back/Home`.
   * **Кнопки `0–9` и цветные кнопки ТВ-пультов (`R/G/Y/B`) → Сцены/Макросы в 1 клик:** например, кнопка `1` включает *«Любимое Jazz-радио + пресет Warm Tube + громкость -32 dB»*, кнопка `2` — *«Вход ТВ-бокса USB + пресет Кино»*.
   * **Избирательный выход из сна (`Selective Standby Wake`):** в режиме ожидания `Standby` стример просыпается **только** от обученной кнопки `Power` (или назначенных кнопок быстрого запуска сцен `1–3`), полностью игнорируя нажатия остальных кнопок телевизионного пульта во время просмотра ТВ.

---

## 7. Протокол обмена `ESP32-S3 ↔ AT32F403` (UART1 Binary v2)

### 7.1. Физический и канальный уровень
* Скорость: старт на **`921600` бод** (с опцией подъёма до `2 000 000` бод в режиме передачи чанков OTA), формат `8N1`, приём через кольцевой DMA + прерывание `IDLE line`.
* Формат кадра (Little-Endian):
  ```text
  +--------+--------+--------+--------+--------+------------------+-------------+
  | SYNC   | LEN    | VER/FL | SEQ    | CMD    | PAYLOAD          | CRC16_CCITT |
  | 0xAA55 | uint16 | uint8  | uint8  | uint8  | 0 .. 1024 bytes  | uint16      |
  +--------+--------+--------+--------+--------+------------------+-------------+
  ```
  * `SYNC`: `0x55, 0xAA` на линии (`0xAA55` LE16); `VER/FL`: старший полубайт = версия протокола (`0x2`), младший = флаги (`ACK_REQ`, `IS_ACK`, `IS_NACK`).
  * Надёжность: подтверждение `ACK/NACK` с номером `SEQ` (таймаут `40 мс`, до `3` повторов), фоновый `HEARTBEAT` раз в `1000 мс`, строгий `Mute-Handshake` перед переключением частоты/входа.

### 7.2. Реестр команд
* **`ESP32 → AT32`:**
  * Транспорт и тракт: `0x01 CMD_MUTE`, `0x02 CMD_UNMUTE`, `0x03 CMD_SET_VOLUME` (дБ + баланс + ReplayGain offset + время рампы), `0x04 CMD_SET_FS` (`44100 / 48000`), `0x05 CMD_SET_I2S_SOURCE` (`ESP / BT_EXT / TONE_TEST`), `0x06 CMD_AB_COMPARE` (`Normal / Bypass RMS-Matched`).
  * Загрузка DSP (все структуры версионированы и упакованы `#pragma pack(push, 1)`):
    * `0x10 CMD_LOAD_HPF_HEADROOM` (`hpf_en, hpf_f0, headroom_mode, manual_atten_db`)
    * `0x11 CMD_LOAD_ROOM_PEQ` (`enable, band_count <= 5, biquad_band_t[5]`)
    * `0x12 CMD_LOAD_USER_PEQ` (`enable, band_count <= 10, biquad_band_t[10]`)
    * `0x13 CMD_LOAD_ANTI_AD` (`mode: OFF/Soft/Aggro, thresh, attack, release, makeup_db`)
    * `0x14 CMD_LOAD_VBB` (`enable, mode, freq_hz, amount, drive, lp_hz, mix`)
    * `0x15 CMD_LOAD_AETHER` (`aether_params_v2_t` — все 12 плавных параметров сцены/воздуха/глубины/гармоник/crossfeed)
    * `0x16 CMD_LOAD_LOUDNESS` (`enable, ref_level_db, bass_boost_max, treble_boost_max`)
    * `0x17 CMD_LOAD_LIMITER` (`ceiling_db, lookahead_ms, release_ms, dither_en`)
    * `0x18 CMD_BYPASS_MASK` (битовая маска мгновенного плавного включения/обхода каждого из 9 блоков + статус `bit_perfect_active`)
    * `0x19 CMD_PRESET_OP` (`Save / Load / Delete / List` пресетов 0..31 во внешней SPI-флешке или Flash AT32)
  * Железо и питание: `0x20 CMD_USB_MUX_CTRL` (`Auto / Force Host / Force Device`), `0x21 CMD_POWER_STATE` (`Active / Standby / Amp Relay`), `0x22 CMD_MCLK_CFG`.
  * Обновление `AT32`: `0x30 CMD_OTA_BEGIN`, `0x31 CMD_OTA_CHUNK` (по 512 байт), `0x32 CMD_OTA_VERIFY_COMMIT`, `0x33 CMD_GET_SYS_INFO` (версия FW, размер SRAM `96/224K`, найденный чип SPI-Flash JEDEC).
* **`AT32 → ESP32`:**
  * `0x80 EVT_STATUS` (`current_fs`, `mute_state`, `bit_perfect_flag`, `usb_vbus_present`, `active_usb_port`, `cpu_load_pct`, `clip_count`, `dc_fault_flag`),
  * `0x81 EVT_SIGNAL_METERS` (точные пики `L/R` до/после DSP и срабатывание лимитера `GR_dB` для стрелочных индикаторов VU),
  * `0x82 EVT_ACK_NACK`, `0x83 EVT_HEARTBEAT`, `0x84 EVT_OTA_PROGRESS`.

---

## 8. Флагманский визуал `OMNIA UI` (`320×240` IPS, 60 FPS I80 + RGB Ring + Лёгкая PWA)

### 8.1. Рендер-движок LVGL без просадок FPS
* Альбомная ориентация `320×240`, шина **8-bit 8080 (`esp_lcd_i80`) с PCLK `20–30 МГц`** и двойной буферизацией DMA во внутренней быстрой SRAM (`2 × 38.4 КБ`).
* Изящная тонкая типографика **Light / Thin / Regular** (`Montserrat / Inter / Roboto` `12..48 px`, `bpp=4` с полным набором кириллицы и кастомных иконок аудио-тракта).
* Плавная инерционная прокрутка, пружинные кривые переходов `Ease-Out Quint (140–180 мс)`, перекрёстное растворение обложек `300 мс` (отражение обложки предрасчитывается один раз при декодировании файла).

### 8.2. 4 Флагманские Темы (`Personas`) + синхрон с кольцом `12× WS2812B`
1. **`Obsidian Cyan` (Основная):** фон `#0A0A0C`, карточки `#14151A` с кантом `#262934`, текст `#F5F5F7` / `#A1A1A6`, акцент ледяной циан `#00D4FF` + золото `#FFB347` для `Bit-Perfect` и `♥`.
2. **`McIntosh Midnight`:** глубокое чёрное стекло `#050708`, изумрудно-бирюзовые шкалы `#00E676` и голубые заголовки `#40C4FF`.
3. **`Warm Tube Amber` (Вечерняя лампа):** тёплый эспрессо `#0F0B08` и янтарный накал `#FF9E3D` (умеет включаться **автоматически** в темноте по датчику освещённости `BH1750`!).
4. **`Dieter Pure`:** строгий матовый графит `#18191C`, швейцарская контрастная вёрстка `#F4F4F6` и сигнальный оранжевый акцент `#FF5722`.

### 8.3. 5 Сменных Визуализаторов на экране воспроизведения (`Now Playing`)
1. **`Studio 16-Band Ballistic`:** 16-полосный анализатор (векторный `FFT 512` с окном Ханна и логарифмической сеткой частот) с упругой баллистикой и зависающими золотыми пиками `Peak-Hold`.
2. **`Dual Analog VU Meter`:** полноэкранные двойные стрелочные индикаторы `L / R` (`-20 .. +3 dB`) с физикой инерции механической стрелки.
3. **`AETHER Stage Scope`:** живой радар ширины и глубины стереосцены `Mid / Side` в реальном времени.
4. **`Liquid Silk Wave`:** плавная светящаяся спектральная волна с мягким градиентным шлейфом.
5. **`Cover Hero / Zen Night`:** крупная обложка `180×180 px` с отражением и чистыми тонкими шрифтами без мигающих элементов.

### 8.4. Экраны на устройстве, Карусели и Живое сердце `RGB`
* **Верхний статус-бар:** иконка входа, часы, индикатор `44.1 / 48 kHz` + золотая точка `Bit-Perfect`, **4-дуговой индикатор уровня Wi-Fi**.
* **Полный набор экранов:** `Boot Splash`, `Now Playing` (+ всплывающая полукруглая дуга громкости `Floating Arc HUD` и полоса `Smart Seek`), карусель входов `Focus Deck` (с живым свечением `USB-DAC` при подключении кабеля), `Library` (крупные обложки, алфавитный быстрый переход, папки, CUE), `Web Radio` (витрины Жанров / Топ / Страны / FLAC / Поиск / Ловец треков / Time-Shift полоса), `Favorites & Smart Genre Shelves`, экран `DSP Signal Path & Presets` (светящаяся цепочка активных звеньев + карусель пресетов + быстрые тумблеры + 2 макро-ручки `Эфир` и `Бас`), `Settings` (включая Мастер обучения ИК-пульта и Wi-Fi), `OTA Ring Screen` и `Standby Screensaver`.
* **Режимы кольца `12× WS2812B` (с автояркостью от `BH1750`):**
  * Музыкальная реакция / мягкое вращение при воспроизведении; медленное дыхание на паузе; приглушённый рубиновый при `Mute`; круговая шкала при вращении громкости и прошивке `OTA`;
  * **Фирменный `Standby Lub-Dub Heartbeat`:** биологически достоверный двойной удар сердца (*быстрый основной импульс `lub` → короткая пауза → более мягкий второй отклик `dub` → длинная диастола `~0.9–1.2 с` с естественной живой вариативностью ритма `±5%`*) в тёплых янтарно-рубиновых или циановых тонах, еле заметный ночью благодаря датчику `BH1750`.

### 8.5. Флагманская Ультра-Лёгкая Веб-морда (`Zero-CPU Smartphone / PC PWA`)
Главный принцип: **смартфон или ПК превращается в полноценный диванный пульт и студийную консоль флагмана, а нагрузка на `ESP32-S3` остаётся около 0% CPU / 0% фонового трафика**:
* **Кэшируемый `gzip`-бандл + `Service Worker`:** веб-приложение мгновенно стартует из локального кэша телефона (`IndexedDB + CacheStorage`), работает как нативное полноэкранное приложение (`Add to Home Screen`) и вообще не дёргает флеш-память ESP32 при повторных открытиях.
* **Строго без спектроанализатора в браузере:** никакого потока FFT-кадров по Wi-Fi! Событийный бинарный WebSocket передаёт крошечный пакет состояния (`64–128 байт`) **только в момент реального события** (смена трека/ICY-тега, нажатие кнопки, подключение USB). Плавный прогресс-бар времени трека (`60 FPS`) интерполируется самим браузером через `performance.now()`.
* **1. Экран «Сейчас играет» и полный транспорт плеера (`Now Playing & Transport`):**
  * Крупная обложка альбома (ESP32 отдаёт сырой байтовый срез встроенного JPEG с заголовками `ETag` / `Cache-Control: immutable` без перекодирования на МК; размытый Glassmorphism-фон рендерит GPU телефона!), название трека/станции, исполнитель, альбом, год, кодек/частота/битрейт и честная цепочка сигнала (`FLAC 24/48 -> AETHER -> 24-bit` или `BIT-PERFECT DIRECT`).
  * Управление `Play / Pause / Stop / Prev / Next`, эластичная перемотка `Smart Seek`, `Shuffle / Repeat / Crossfade`, регулятор громкости в дБ (`0.5 dB` шаг + колёсико мыши / жесты), баланс, `Mute`, выбор входа (`USB / MicroSD / Web-Radio / DLNA / AirPlay / SMB / USB-DAC / BT`), таймер сна и кнопка `Standby (lub-dub)`.
  * **Эксклюзивы для Веб-Радио:** шкала живой перемотки эфира `Radio Time-Shift` (`пауза + отмотка на 1.5–2 мин назад`), кнопка **«Сохранить играющую песню с самого начала» (`Retroactive Track Ripper` в `/Radio_Drops/`)** и живой журнал последних 50 песен эфира (`Radio Track Catcher` с копированием названия в 1 тап).
  * **Синхронные тексты песен (`.lrc` караоке) и HD-обложки без участия ESP32:** браузер смартфона сам напрямую запрашивает синхронную лирику в `LRCLIB API` и обложки в `MusicBrainz / CoverArtArchive` через интернет телефона — `0 байт` нагрузки на ESP32!
* **2. Фонотека, Очередь, Плейлисты (`M3U8 / CUE`) и Каталог 40 000+ Радиостанций (100% на стороне клиента):**
  * **Нулевой парсинг JSON на ESP32:** бинарный индекс `.omnia.db`, листы `.cue` и плейлисты `.m3u8` отдаются потоковым чтением (`sendfile`/DMA) как сырой `ArrayBuffer`, а смартфон/ПК за `< 2 мс` строит виртуальный список на `10 000+` треков (60 FPS), мгновенный поиск по кириллице и латинице, очередь `Up Next` с перетаскиванием (`Drag & Drop`), создание/редактирование плейлистов `.m3u8`, 3-уровневое Избранное и авто-закладки аудиокниг.
  * **Прямой поиск радио со смартфона:** браузер сам обращается по HTTPS к глобальной базе `Radio Browser API` (фильтр по странам, жанрам, битрейту и `Lossless FLAC Radio`), а в ESP32 улетает лишь короткая команда `~120 байт` (`URL + название`) при запуске станции или сохранении в пресет!
* **3. Студийная консоль DSP, `AETHER` и Рум-коррекция с задержками колонок:**
  * Интерактивный `60 FPS` график суммарной кривой АЧХ (`10 полос User PEQ + 5 полос Room PEQ`, мультитач `Pinch` для добротности `Q` и `Drag` для частоты/усиления), импорт текстовых файлов `REW / AutoEQ`.
  * **Калькулятор временны́х задержек и фазы АС (`Room Time-Alignment`):** пользователь вводит рулеткой расстояние в сантиметрах от кресла до левой и правой колонки (например, `L = 185 см`, `R = 245 см`) — браузер сам вычисляет задержку ближней АС (`Δt = 60 см / 34.3 = 1.75 мс` с точностью `~3.4 мм`), позволяет подстроить калибровочный трим L/R (`дБ`), проверить полярность клемм (`0° / 180°`) и сравнить результат кнопкой **`A/B Instant Compare`**.
  * Полная панель всех 12 параметров `Studio AETHER`, `VBB`, `Dynamic Loudness ISO 226`, `Anti-Ad 2.0`, плюс сохранение/экспорт/импорт всех 32 пресетов одним файлом бэкапа.
* **4. Пульты ИК, Будильник и Безопасный `Smart OTA`:**
  * Визуальный менеджер 3 самообучаемых ИК-пультов и назначение «умных сцен» на кнопки `0–9` / цветные кнопки (любимое радио + пресет DSP + тема подсветки), музыкальный будильник с плавным нарастанием громкости, карточка диагностики железа (`PSRAM`, `RSSI`, `% CPU AT32`, чип `SPI Flash SFDP`) и загрузка `omnia_update.pkg` с предварительной проверкой `SHA-256 / CRC32` прямо в браузере до начала передачи.

---

## 9. Разметка памяти `ESP32-S3` (16 МБ Flash + 8 МБ Octal PSRAM)

### 9.1. Таблица разделов `partitions.csv` (16 МБ)
| Имя раздела | Тип / Подтип | Смещение | Размер | Назначение |
| :--- | :--- | :---: | :---: | :--- |
| `nvs` | `data / nvs` | `0x009000` | `24 КБ` | Wi-Fi, коды обученных ИК-пультов, последние состояния, калибровки. |
| `otadata` | `data / ota` | `0x00F000` | `8 КБ` | Флаги активного слота и самопроверки `ESP_OTA_IMG_PENDING_VERIFY`. |
| `phy_init` | `data / phy` | `0x011000` | `4 КБ` | Радиокалибровки Wi-Fi. |
| `ota_0` | `app / ota_0` | `0x020000` | `3.5 МБ` | Основной слот прошивки `ESP32-S3` (с запасом под все шрифты и кодеки). |
| `ota_1` | `app / ota_1` | `0x3A0000` | `3.5 МБ` | Резервный слот для безотказного `Smart OTA` с авто-откатом. |
| `storage` | `data / littlefs` | `0x720000` | **`~8.87 МБ`** | Сжатая PWA, кэш обложек и иконок радио, избранное, плейлисты, профили `room.json`, журнал «Находок радио». |

### 9.2. Последовательность питания и бесщёлчкового `Anti-Pop`
* **Включение:** подача питания → затвор `PB0 (DAC_XSMT)` и `PB1/PB10 (AMP/RELAY)` прижаты внешними резисторами `10 кОм` к `GND` (полная тишина на выходе) → старт `AT32`, запуск чистого клока `I2S2` с нулевыми сэмплами → пауза стабилизации переходных процессов ЦАПа `150 мс` → замыкание реле УМ → плавное поднятие `DAC_XSMT = HIGH`.
* **Выключение / уход в `Standby`:** плавная рампа громкости в `-∞ dB` за `30 мс` → `DAC_XSMT = LOW` → `AMP_MUTE` → размыкание реле → перевод шин в энергосбережение и включение сердечного ритма `lub-dub`.

---

## 10. Поэтапный план реализации (Milestones 1 → 10)

1. **Этап 1 — Каркас репозитория, общий протокол и ядро `AT32`:** настройка монорепозитория PlatformIO, `omnia_pins.h`, `omnia_protocol.h + CRC16`, раскрытие `224 КБ SRAM`, универсальный драйвер SPI-Flash (`JEDEC + SFDP`), бесщёлчковый `Anti-Pop`, `I2S2 Master` + тестовый генератор синуса и базовый обмен по UART1.
2. **Этап 2 — Связка `ESP32-S3 ↔ AT32` по I2S и UART:** сквозная передача звука `ESP32 Slave TX → 74HC125 → AT32 Master → PCM5102A`, полный `Mute-Handshake` при смене `44.1 / 48 кГц`, проверка чистого `Bit-Perfect`.
3. **Этап 3 — Бронебойный аудиодвижок и `True Gapless`:** статические пулы `PSRAM + SRAM DMA`, чтение `SD SPI` и `USB Host`, декодеры `FLAC / MP3 / AAC / WAV / Ogg / Opus`, бесшовный `Gapless` (`Lookahead + LAME/Xing trim`), парсер `CUE + FLAC`, быстрый индекс `.omnia.db` и `Smart Elastic Seek`.
4. **Этап 4 — Полный студийный DSP на `AT32`:** реализация всех 9 звеньев (`HPF`, `Headroom`, `5 Room + 10 User PEQ`, `Anti-Ad`, `VBB`, все ручки `AETHER Studio`, `Dynamic Loudness`, `True-Peak Limiter`), плавные рампы `20–50 мс`, `A/B Instant Compare` и хранение 32 пресетов.
5. **Этап 5 — Дисплей `I80 8-bit ST7789` и флагманский `OMNIA UI`:**(после сверки фото спинки дисплея `TENSTAR`) запуск `esp_lcd_i80` на `60 FPS`, 4 темы `Personas`, 5 визуализаторов (`16-Band FFT`, `Dual VU`, `AETHER Scope`, `Silk Wave`, `Zen`), карусели, `Signal Path`, энкодер `PCNT`, 7 кнопок `ADC1`, автояркость `BH1750` и кольцо `WS2812B` с живым пульсом `lub-dub`.
6. **Этап 6 — Самообучаемый ИК-пульт (`Smart IR`):** захват `RMT RX`, декодер протоколов + универсальный `Raw Hash`, мастер обучения с двойным подтверждением, поддержка удержания, макросы на кнопки `0–9` и пробуждение из `Standby`.
7. **Этап 7 — Флагманское Веб-Радио и Сетевые источники:** каталог `Radio Browser API`, старт за `0.6 с`, живая пауза и перемотка эфира `Radio Time-Shift`, запись трека с начала `Retroactive Ripper`, «Ловец треков», `Anti-Ad 2.0`, `Lossless FLAC Radio`, плюс сетевые источники `DLNA / AirPlay 1 / SMB`.
8. **Этап 8 — Ультра-лёгкая смартфонная `PWA`:** сборка однофайлового `gzip` веб-приложения с `Service Worker`, тач-редактор кривых `Room/User PEQ` (с импортом `REW / room.json`), пульт студийных настроек `AETHER/VBB`, управление библиотекой, радио и ИК-обучением через бинарный мост WebSocket.
9. **Этап 9 — Горячее переключение `USB Host ↔ USB-DAC UAC1`:** логика `FSUSB30MUX` + `AO3401` + `VBUS_DET`, бесшовная смена роли USB на лету без ребута за `~0.5 с` (автоматический переход на звук с ПК / Android / ТВ-бокса и возврат к флешке).
10. **Этап 10 — Двухфазный `Smart OTA`, защита и финальная полировка:** пакет `omnia_update.pkg` с обновлением обоих МК и откатом, стресс-тест 24/7 без утечек памяти, контроль нагрева, проверка `60 FPS` и идеальной тишины при переходных процессах.

---

### Статус аппаратной готовности и документации
* [x] **Фото обратной стороны дисплея `TENSTAR ROBOT 2.8" ST7789` (ПРОВЕРЕНО):** перенос одного резистора `R16 → R15` (`IM = 001`), шлейф `FFC 16-pin 1.0mm`, памятка: `docs/ST7789_8080_8P_MOD_GUIDE.png`.
* [x] **Принципиальные схемы включения микросхем, транзисторов и поэтапной сборки (ГОТОВО):** сохранены в `docs/OMNIA_SCHEMATIC_IC_TRANSISTORS.png` и `docs/OMNIA_WIRING_STAGE1_CORE.png` (включая работу **без `FSUSB30MUX`** через родной порт `USB/OTG` `ESP32-S3` или 2 прямые перемычки `GPIO19/20`).
* [x] **Монорепозиторий `ChillPulse/omnia-v-core` + Этапы 1, 2 и полный студийный DSP на `AT32` (включая задержки и фазу АС в рум-коррекции) — РЕАЛИЗОВАНЫ И СОБРАНЫ В CI.**
