ChillPulse/omnia-v-core/docs/OMNIA_SCHEMATIC_IC_TRANSISTORS.png

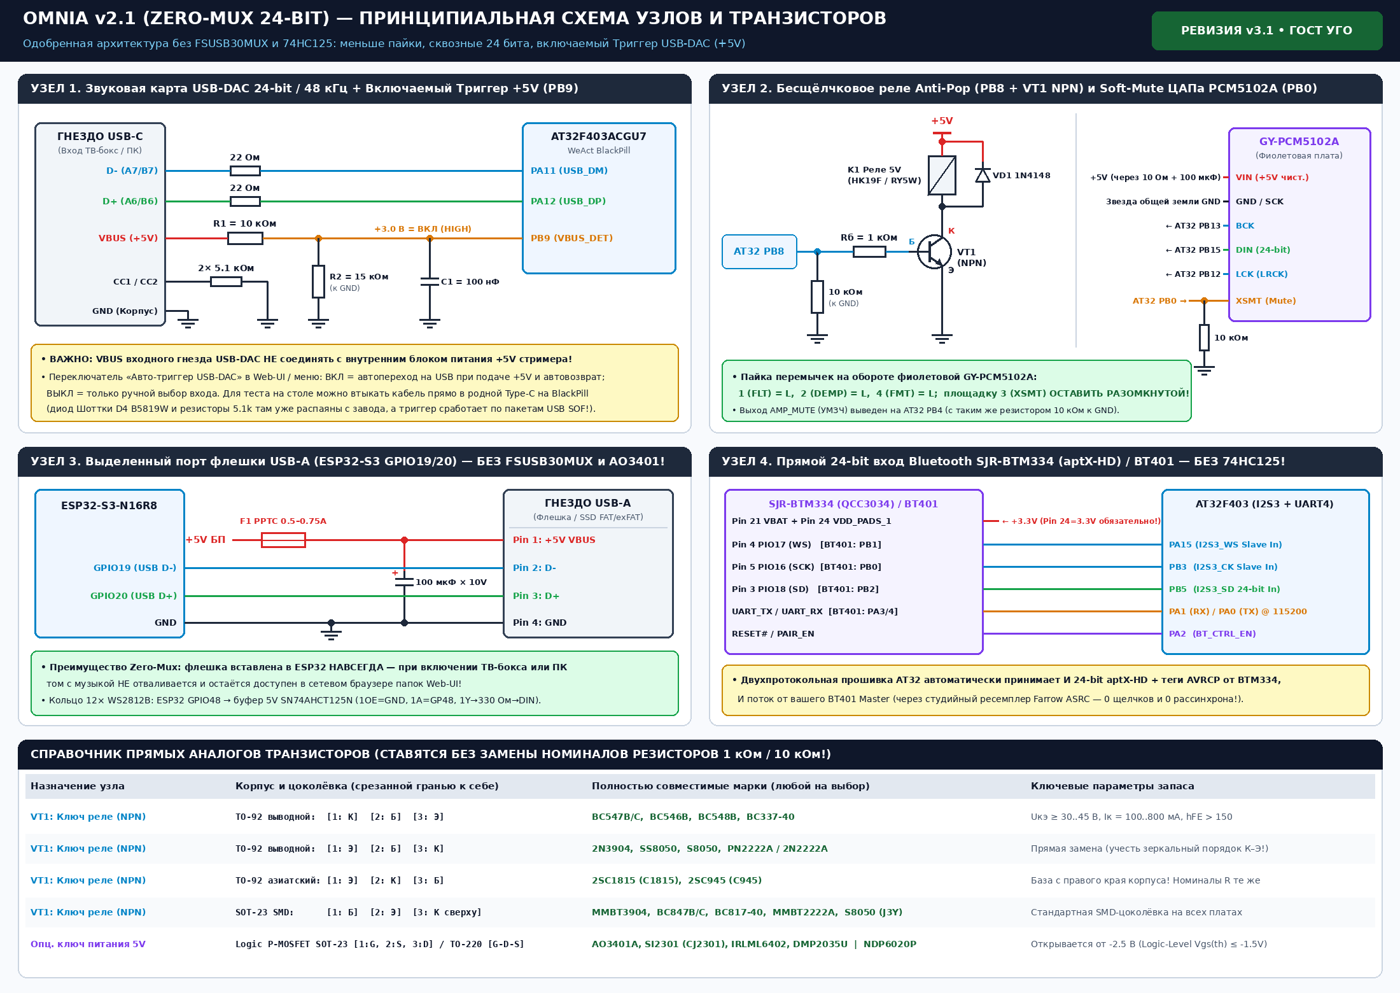
docs/OMNIA_SCHEMATIC_IC_TRANSISTORS.png
