ChillPulse/omnia-v-core/docs/OMNIA_WIRING_STAGE1_CORE.png

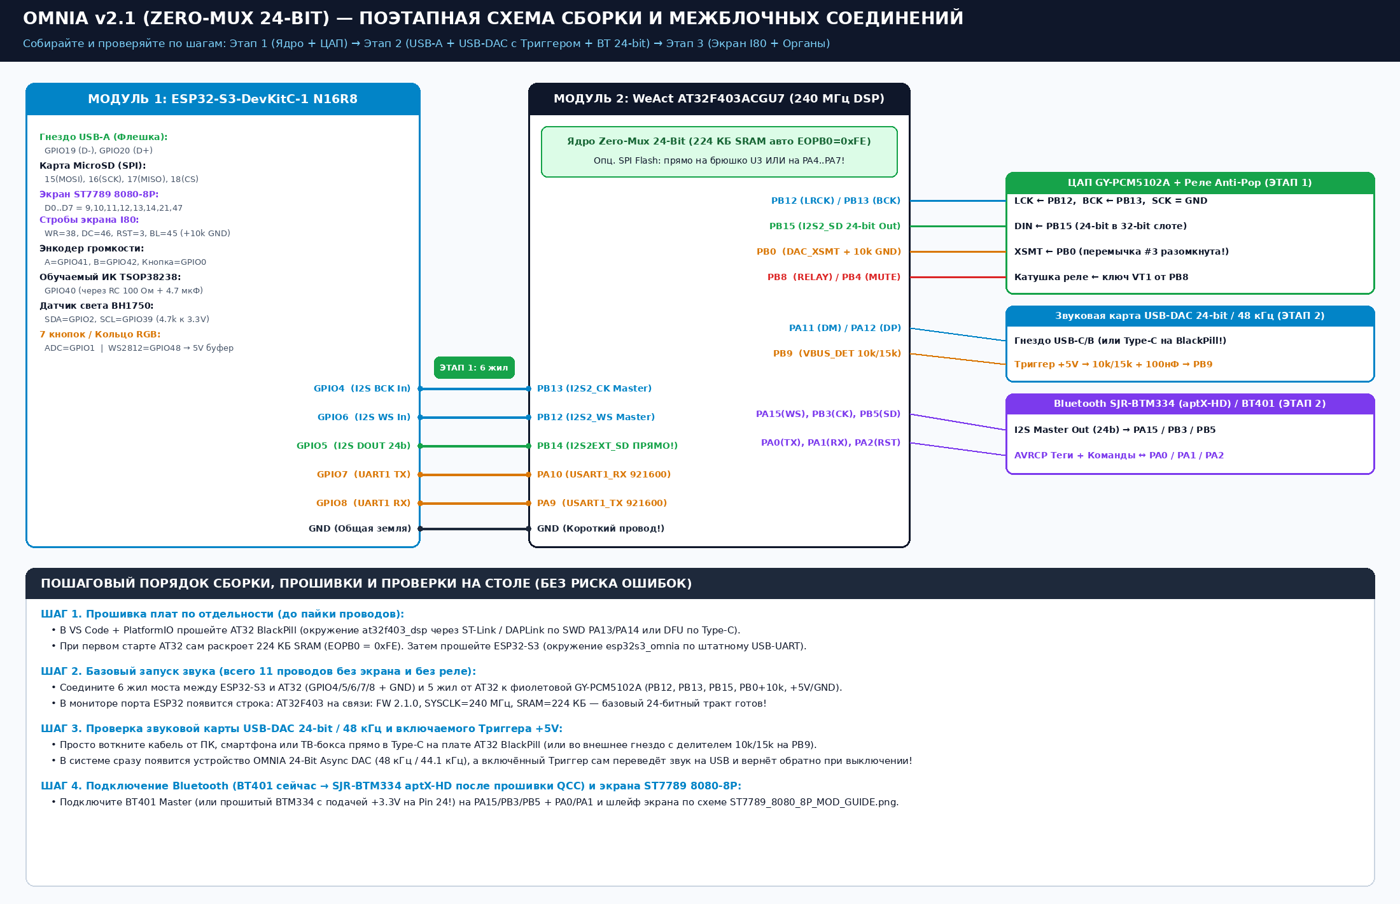
docs/OMNIA_WIRING_STAGE1_CORE.png
