ChillPulse/omnia-v-core/(commit log)

2026-10-09 Omnia (v-core): initial scaffold per TЗ (unbuilt)
    [partitions.csv]
2026-10-09 SD pins -> CS10/SCK15/MISO8/MOSI2 (off PSRAM); I2C SDA -> GPIO38 (GPIO14 is display SCL); README
2026-11-08 feat(omnia-v2): unified PlatformIO + ESP-IDF v5.x & AT32F403 240MHz studio DSP monorepo
    [partitions.csv]
2026-11-08 feat(room-dsp & docs): add L/R speaker fractional delay + phase/trim, zero-CPU Web-UI spec & visual wiring schematics
2026-11-08 docs(schematics): draw explicit 74HC125 pin 3-6 bridge, separate PB8 GOST resistors & drop-in MOSFET/NPN table [skip ci]
2026-11-12 feat(v2.1): Zero-Mux 24-bit architecture, UAC1 Async 48/44.1k DAC + toggleable +5V trigger, Farrow ASRC & BTM334/BT401 dual BT, v3.1 GOST schematics
2026-11-12 fix(at32): enable USB_MODULE_ENABLED and ACC_MODULE_ENABLED in at32f403a_407_conf.h
    [at32f403a_407_conf.h]
